titos-carrasco/6502-VirtualDevices/pdf/6502-Mega-Simple-Oled.pdf

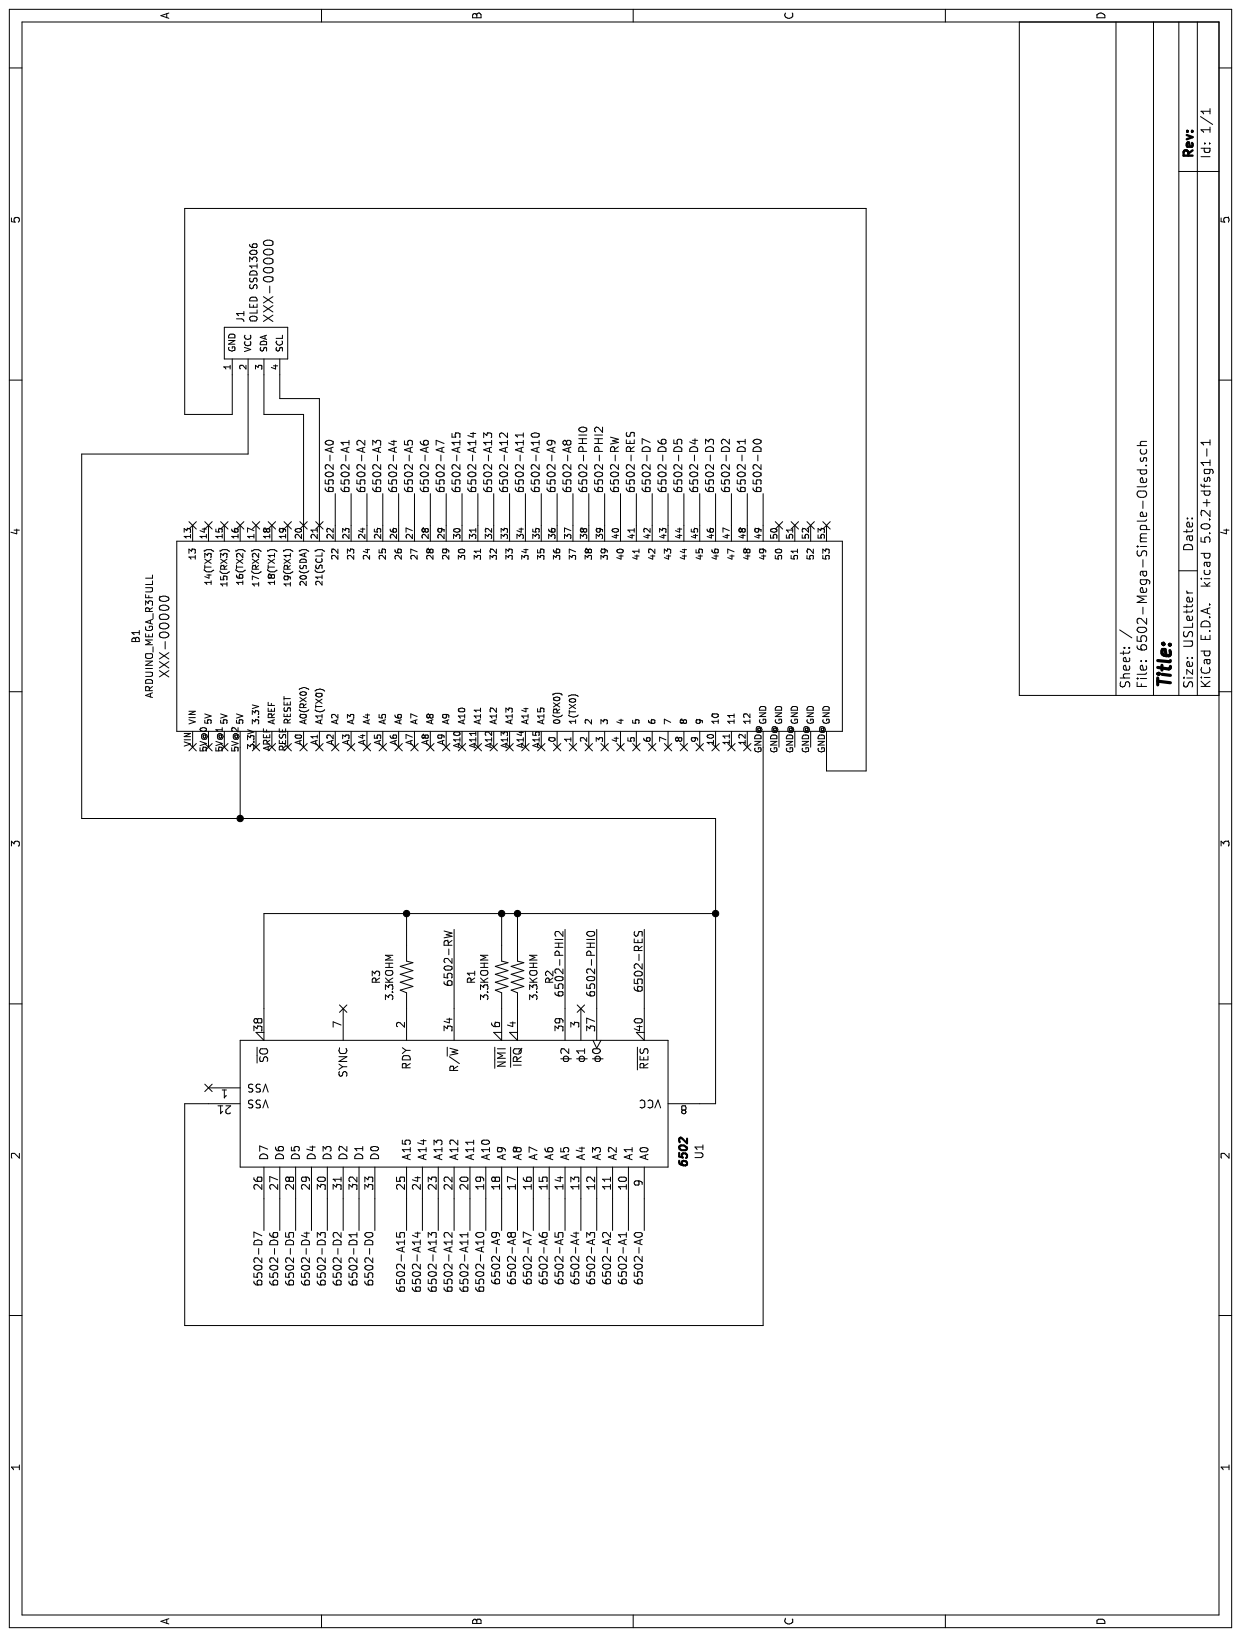
[picture p7: page 1]
