titos-carrasco/6502-VirtualDevices/pdf/6502-Mega-Simple.pdf

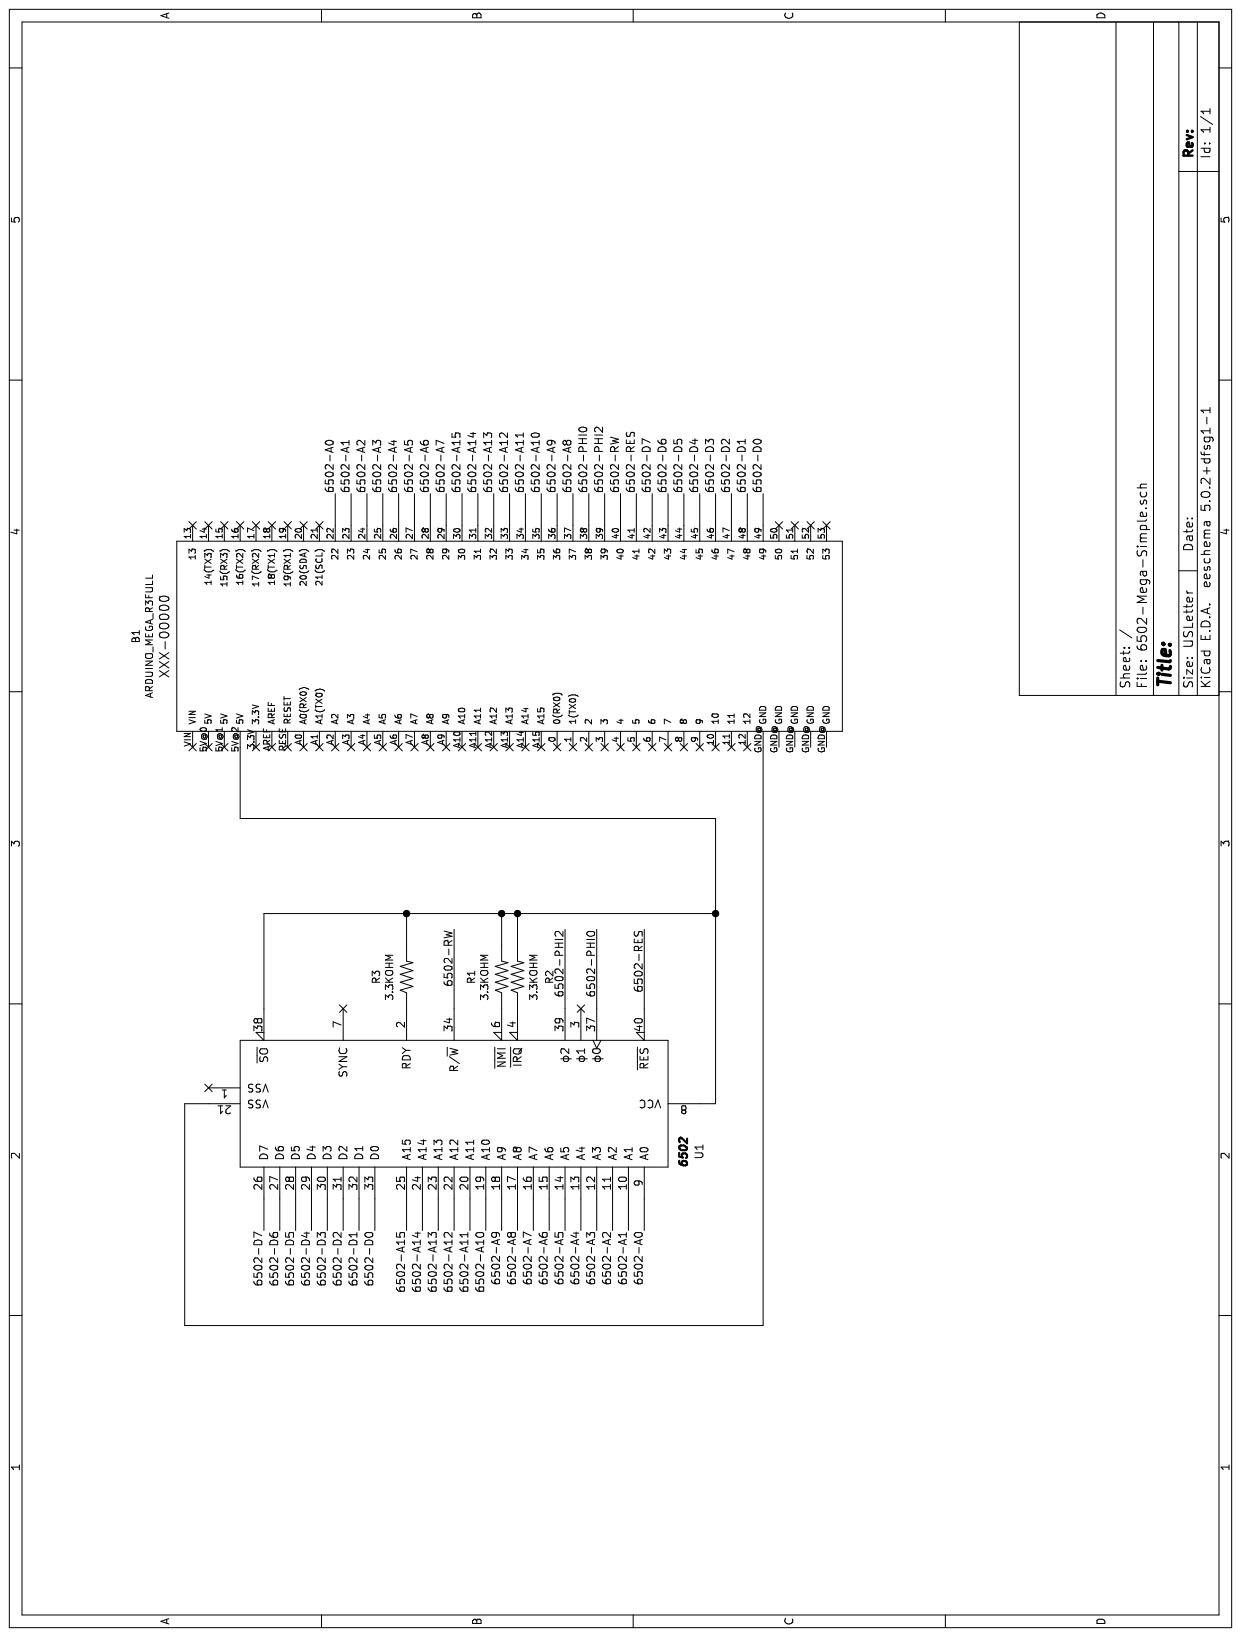
[picture p8: page 1]
