titos-carrasco/6502-VirtualDevices/(commit log)

2019-04-04 Added link to pdf kicad diagrams
2019-04-08 Add Serial communication to a "memory/devices" provider
2019-04-11 Fix Arduino Mega USB 1ms delay
    [6502-Mega-FunctionalTest.py, 6502-Mega-Serial.ino]
